osptek/devkit-fake_pod_nano_pro/tfcard/txt/说明.txt

## 组装流程和制作说明
* PCB厚度为1.0，不要打错了
* S3芯片和屏幕之间需要一个厚度1.5mm的导热硅垫，请务必不要忘记
* 电池的控制板部分可能需要稍微的扳一下以贴合USB口，然后刚好可以塞进去
* 外壳中间有滑轨，请确认塞到位，注意屏幕的玻璃有台阶，会刚好卡在外壳内，不要大力出奇迹
* 部分部件的购买链接详见附件，可自行参考
* 阻容大部分是0402，所以可能需要钢网+加热台才能焊接好
* 所有板子都已经过验证无误，有问题请检查焊接
* 外壳建议使用PLA-CF材料，尼龙材料悬空的横杠坚固度不够
* PCM5102版的耳机处的电阻470r和2.2nf，如耳机音量较小，可试着换成 68Ω + 10nF
* 实测效果：CS43131驱动耳机音量上限很高，且音质更好，但接音响时，音量反而没有PCM5102大，因为PCM5102是LINE OUT。 具体我也不太懂
* 附件提供了一个固件便捷烧录工具，一键烧录
* 制作交流群（739444215）,未尽之处请进群沟通吧，寻求帮助之前请仔细阅读本制作说明
