osptek/devkit-fake_pod_nano_pro/tfcard/night7/nocover.jpg

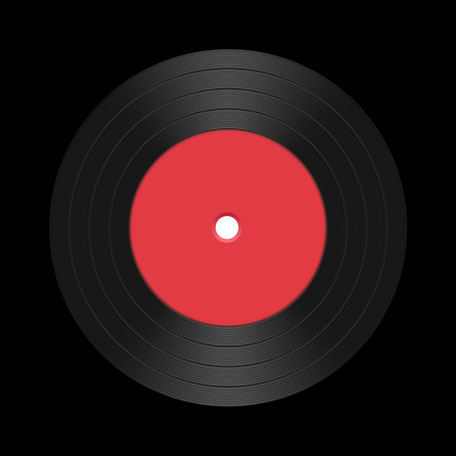
tfcard/night7/nocover.jpg
