osptek/devkit-fake_pod_nano_pro/tfcard/night7/uacbg.jpg

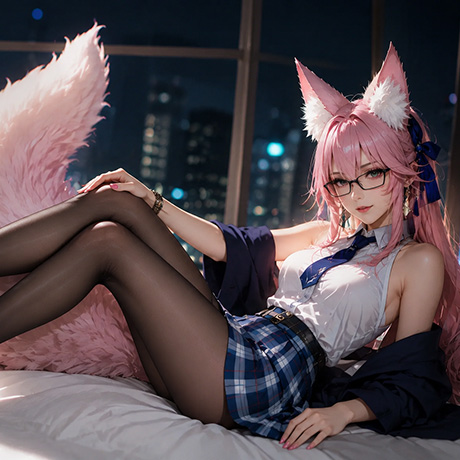
tfcard/night7/uacbg.jpg
