osptek/devkit-fake_pod_nano_pro/tfcard/pic/460_p1.jpg

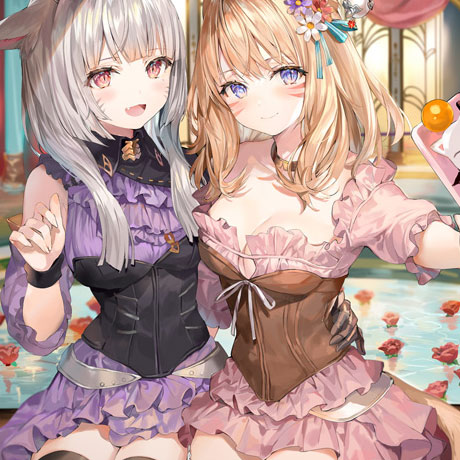
tfcard/pic/460_p1.jpg
