osptek/devkit-fake_pod_nano_pro/tfcard/pic/460_p2.jpg

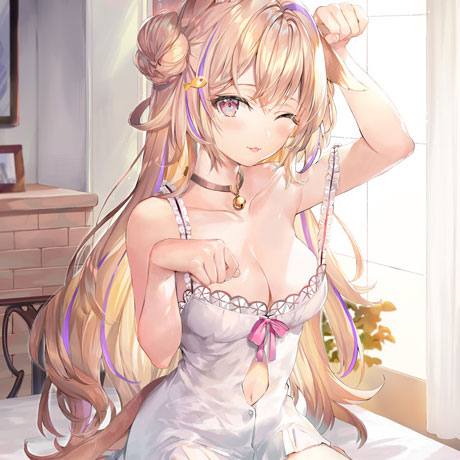
tfcard/pic/460_p2.jpg
