osptek/devkit-fake_pod_nano_pro/hardware/enclosure/FakePod_S31_LeftCover_BlackAcrylic.step

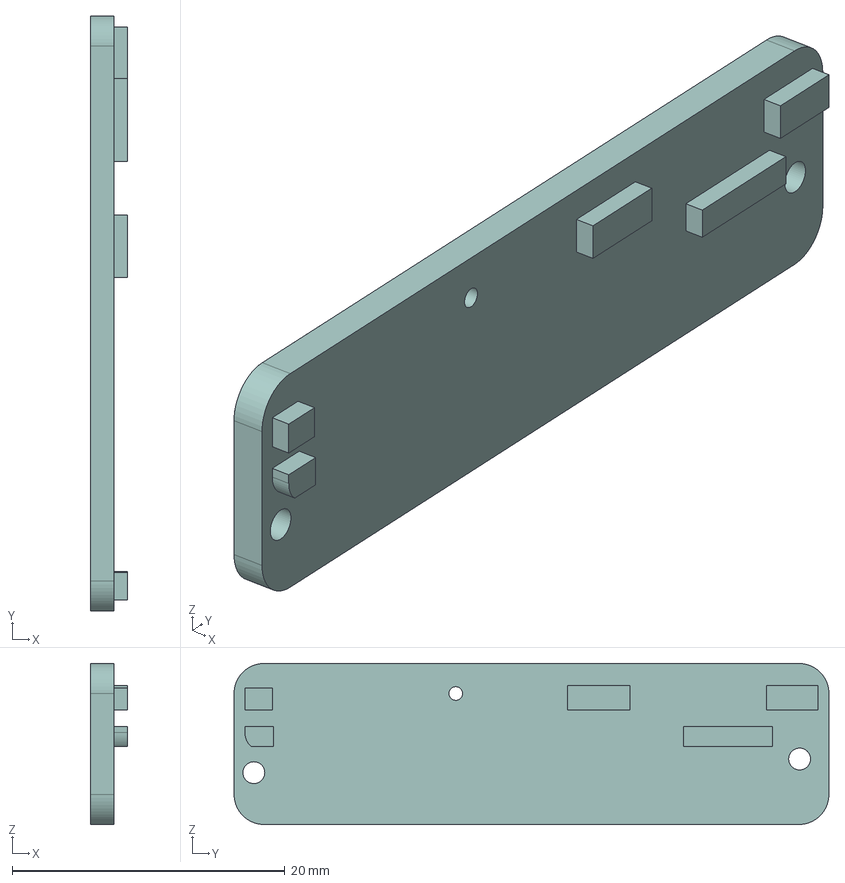
[picture p8: CAD file, 2026-11-11]
hardware/enclosure/FakePod_S31_LeftCover_BlackAcrylic.step
2.70 x 43.6 x 11.8 mm
