osptek/devkit-fake_pod_nano_pro/hardware/enclosure/FakePod_S31_Body_Aluminum_CNC.step

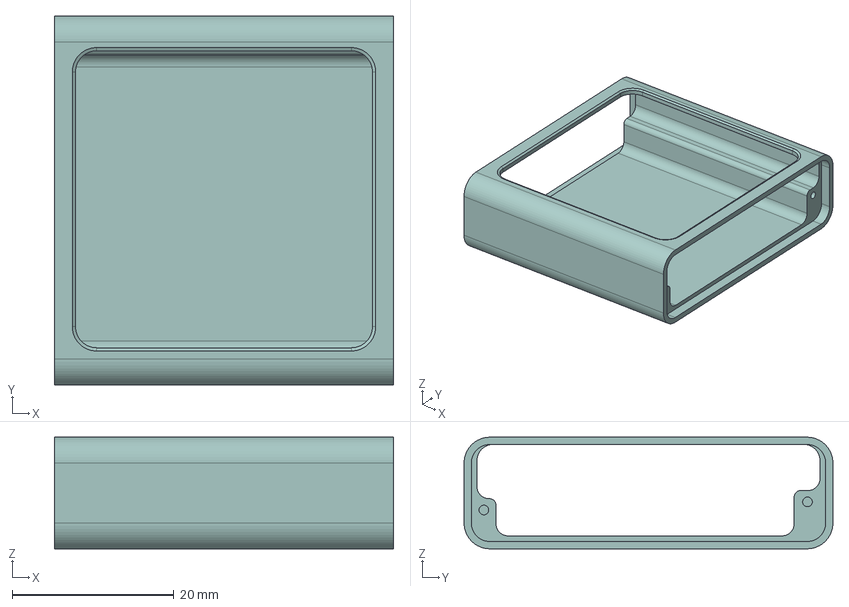
[picture p9: CAD file, 2026-11-11]
hardware/enclosure/FakePod_S31_Body_Aluminum_CNC.step
41.9 x 45.6 x 13.8 mm
