osptek/devkit-fake_pod_nano_pro/hardware/enclosure/FakePod_S31_RightCover_Aluminum_CNC.step

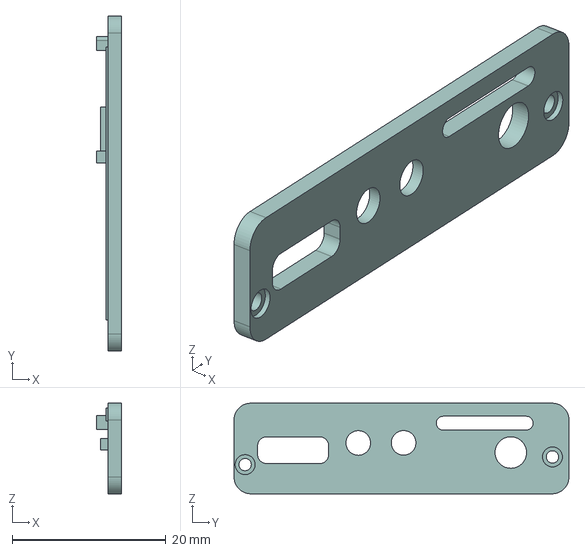
[picture p10: CAD file, 2026-11-11]
hardware/enclosure/FakePod_S31_RightCover_Aluminum_CNC.step
3.20 x 43.6 x 11.8 mm
