osptek/devkit-fake_pod_nano_pro/hardware/FakePod_S31_Schematic_V1.0.pdf

## VBUS

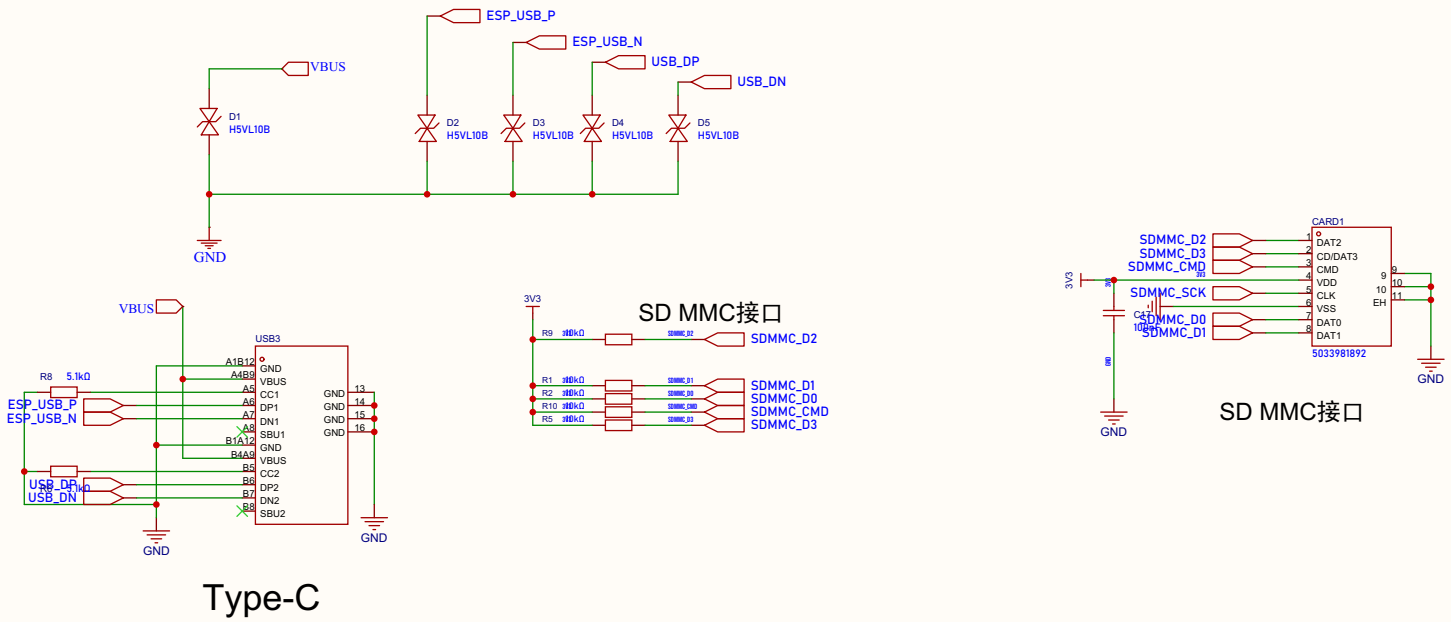
[picture p11: page 1]

GND
SBU2 B8 DN2 B7 DP2 B6 CC2 B5 VBUS B4A9 GND B1A12 SBU1 A8 DN1 A7 DP1 A6 CC1 A5 VBUS A4B9 GND A1B12

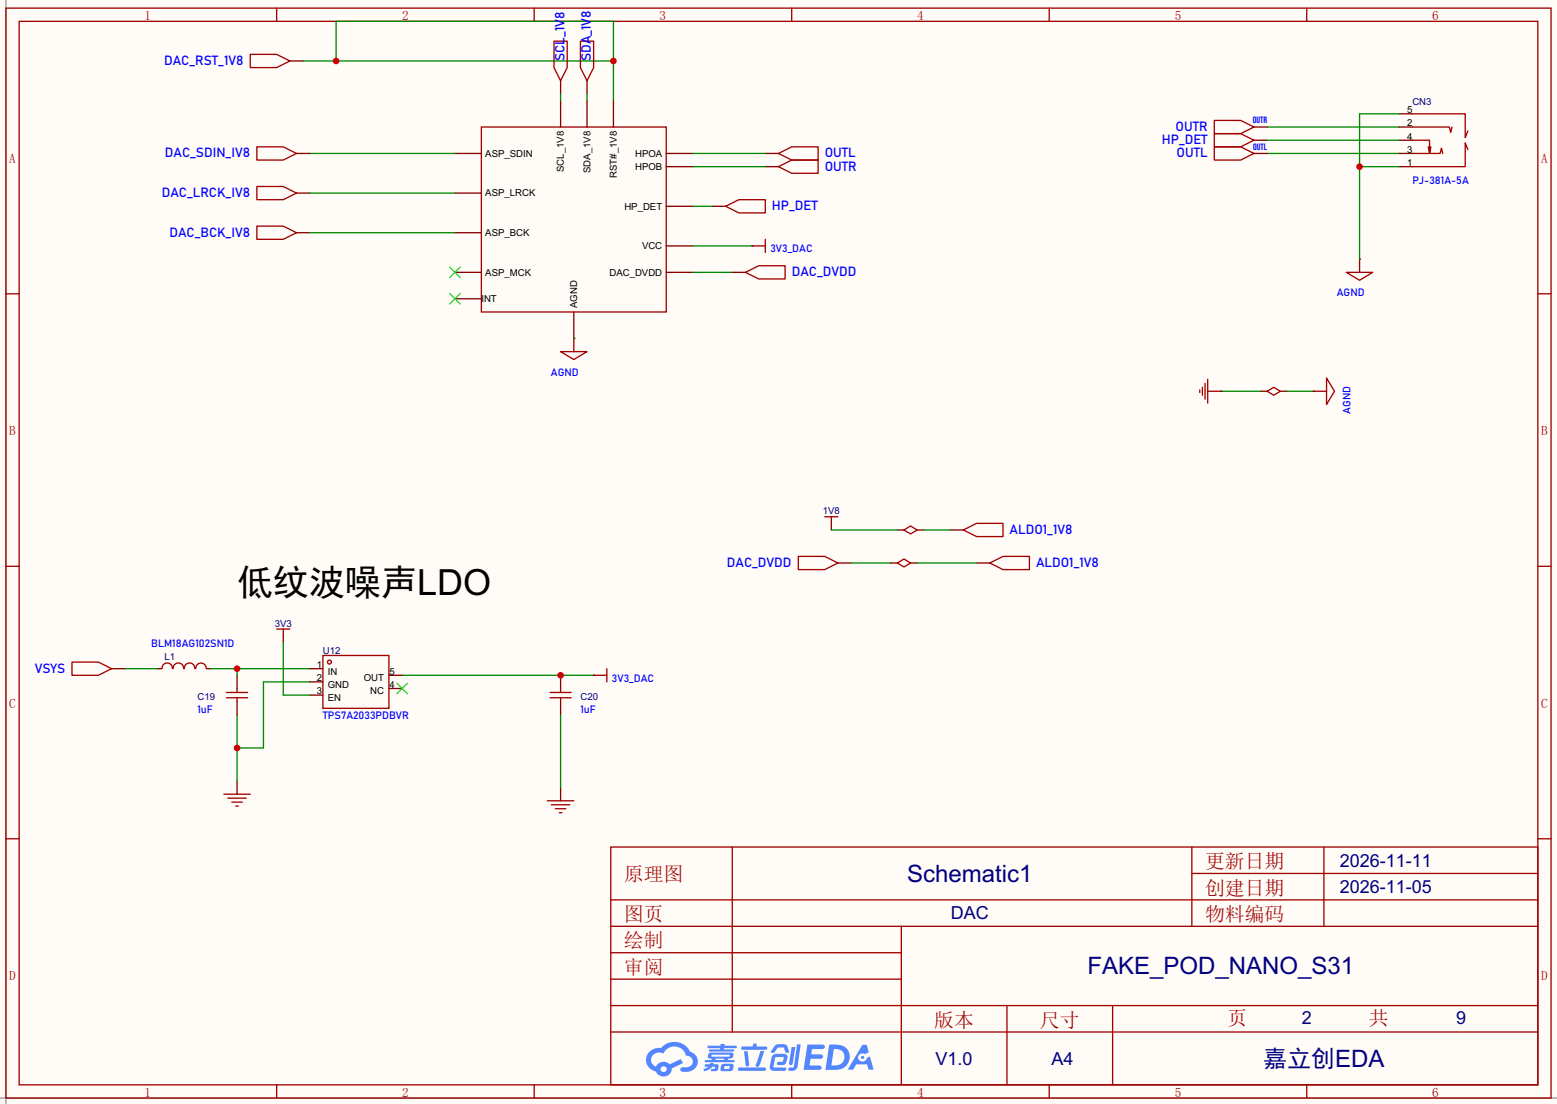
[picture p12: page 2]

AGND | AGND

### AGND

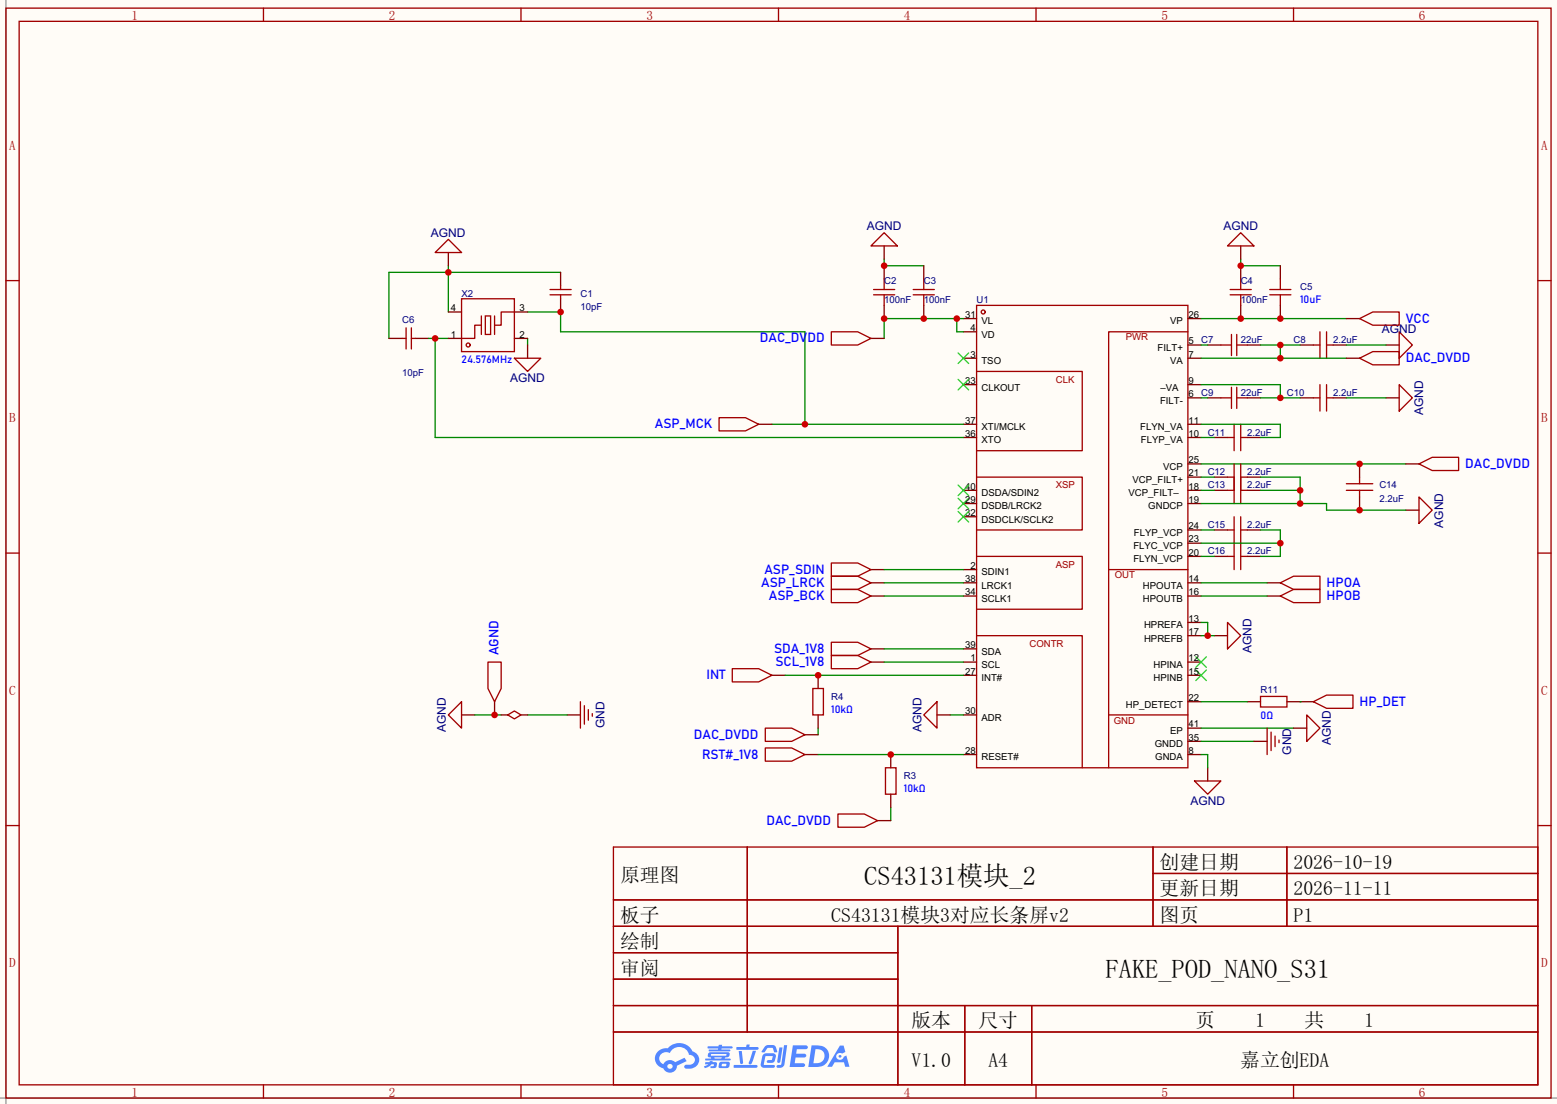
[picture p13: page 3]

原理图 | CS43131模块_2 | 创建日期 | 2026-10-19

更新日期 | 2026-11-11

板子 | CS43131模块3对应长条屏v2 | 图页 | P1
绘制 | | FAKE_POD_NANO_S31
审阅

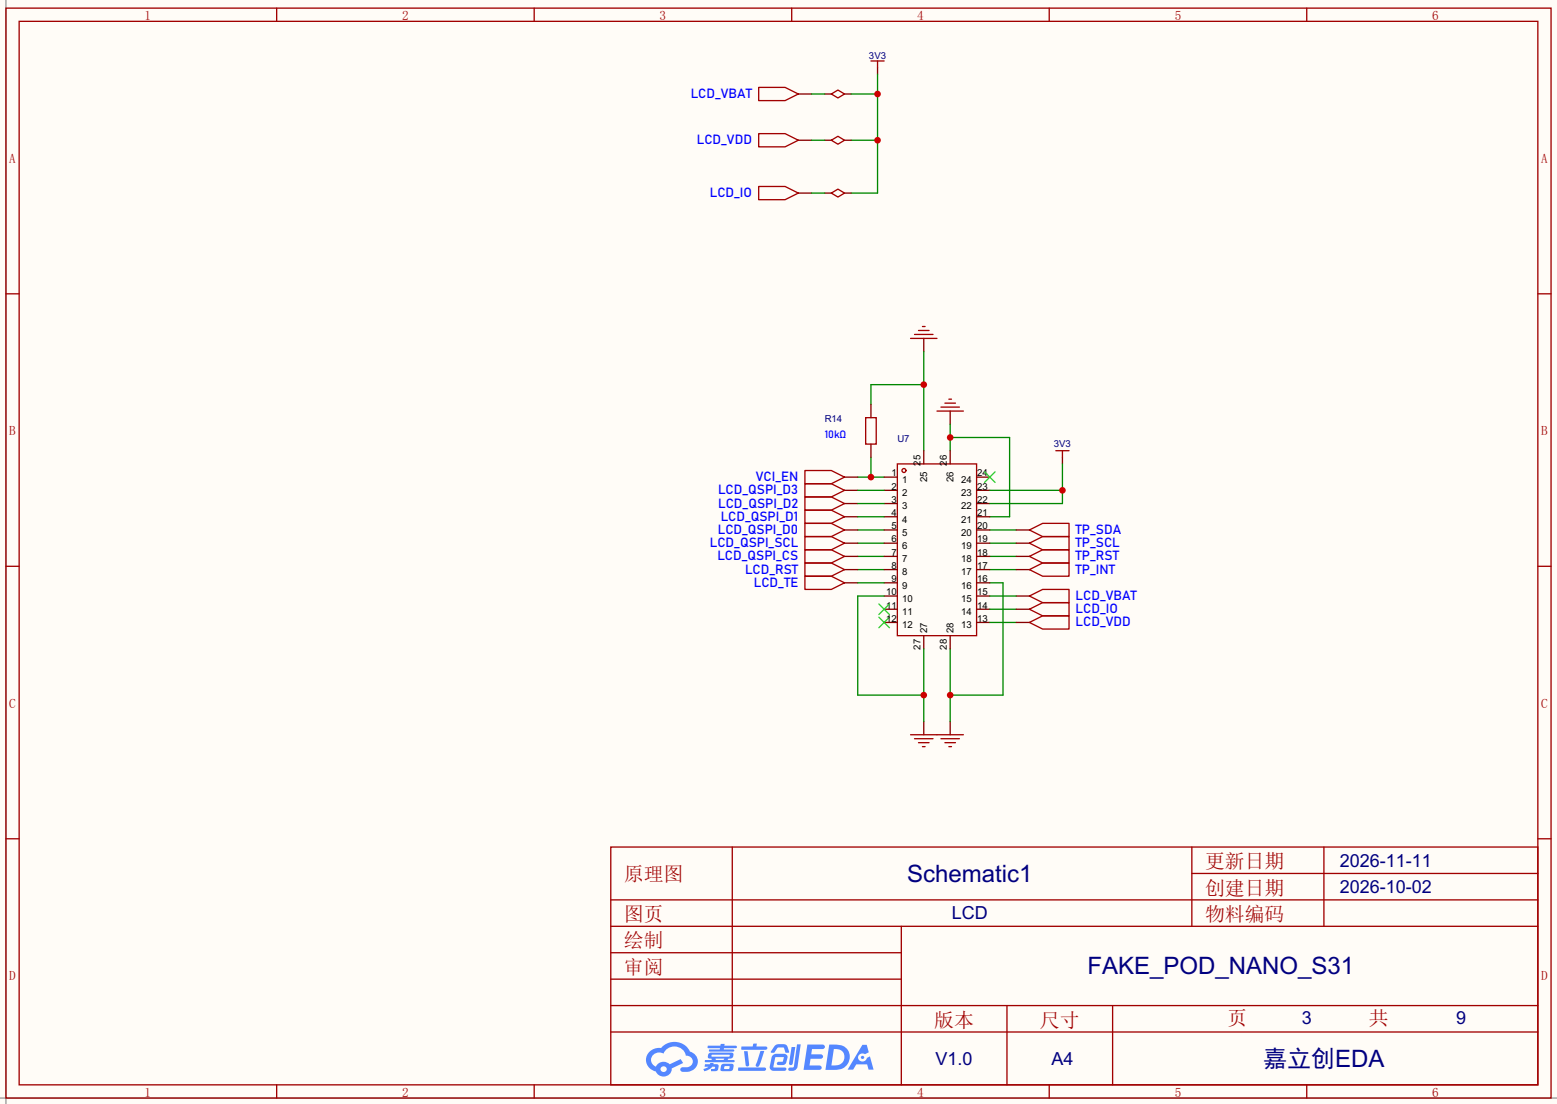
[picture p14: page 4]

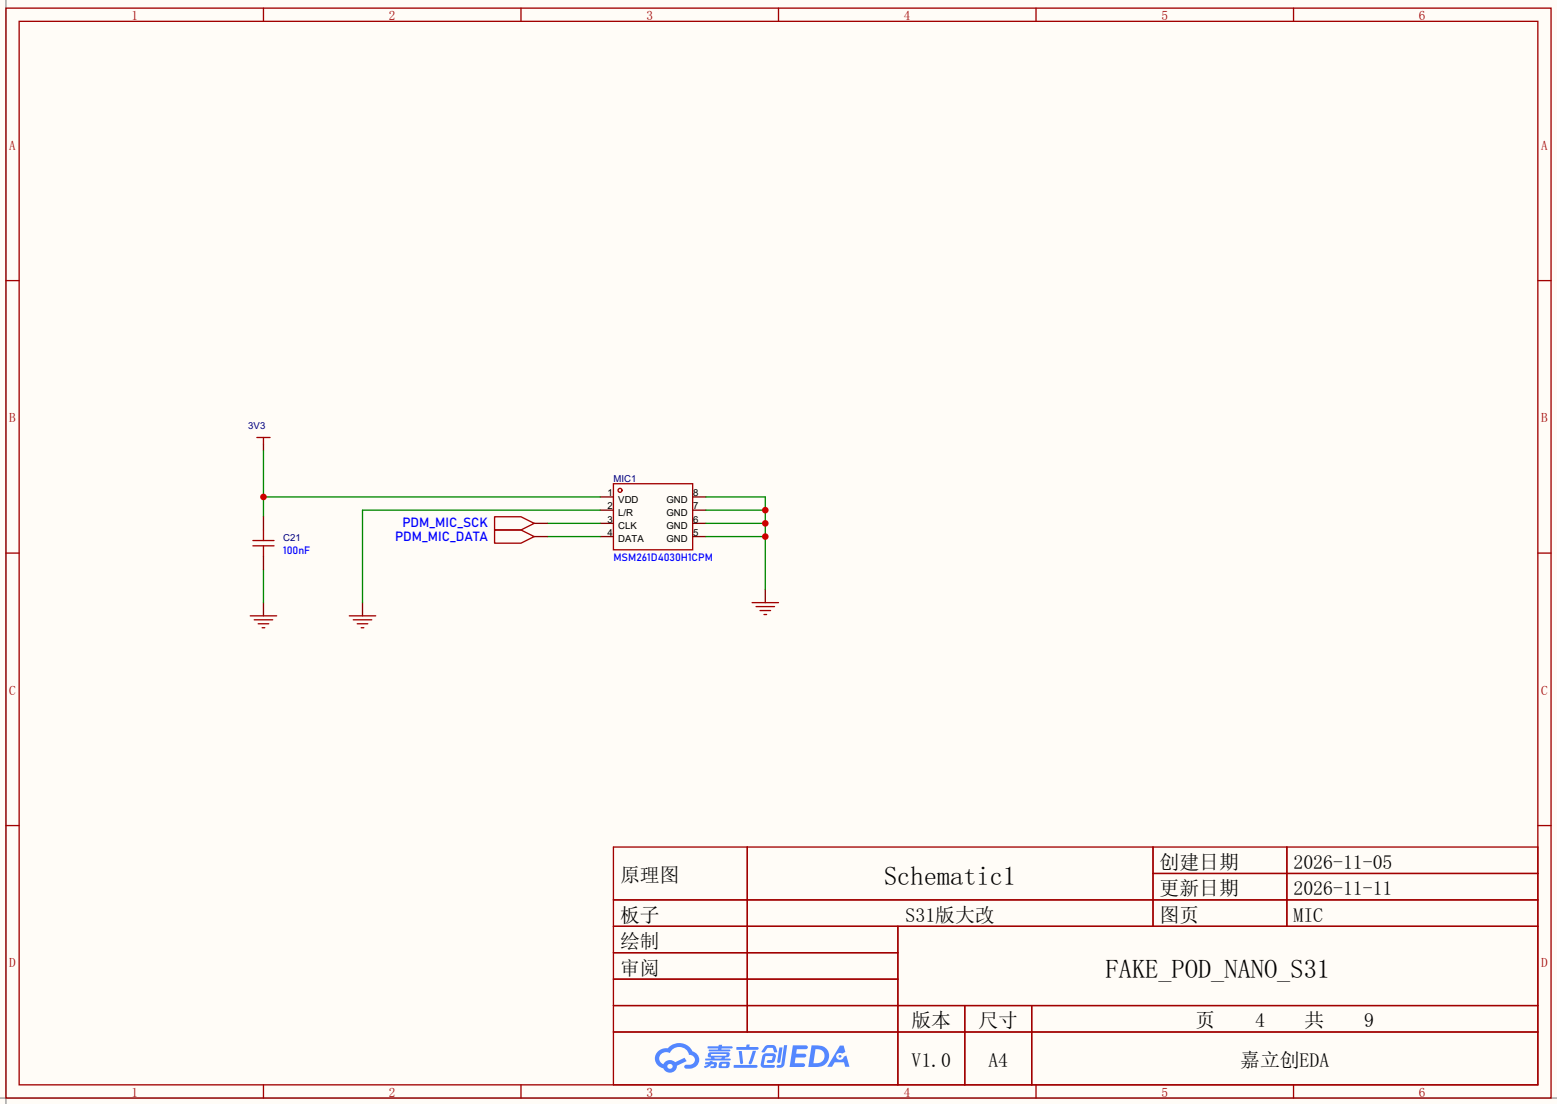
[picture p15: page 5]

原理图 | Schematic1 | 创建日期 | 2026-11-05

更新日期 | 2026-11-11

板子 | S31版大改 | 图页 | MIC
绘制 | | FAKE_POD_NANO_S31
审阅

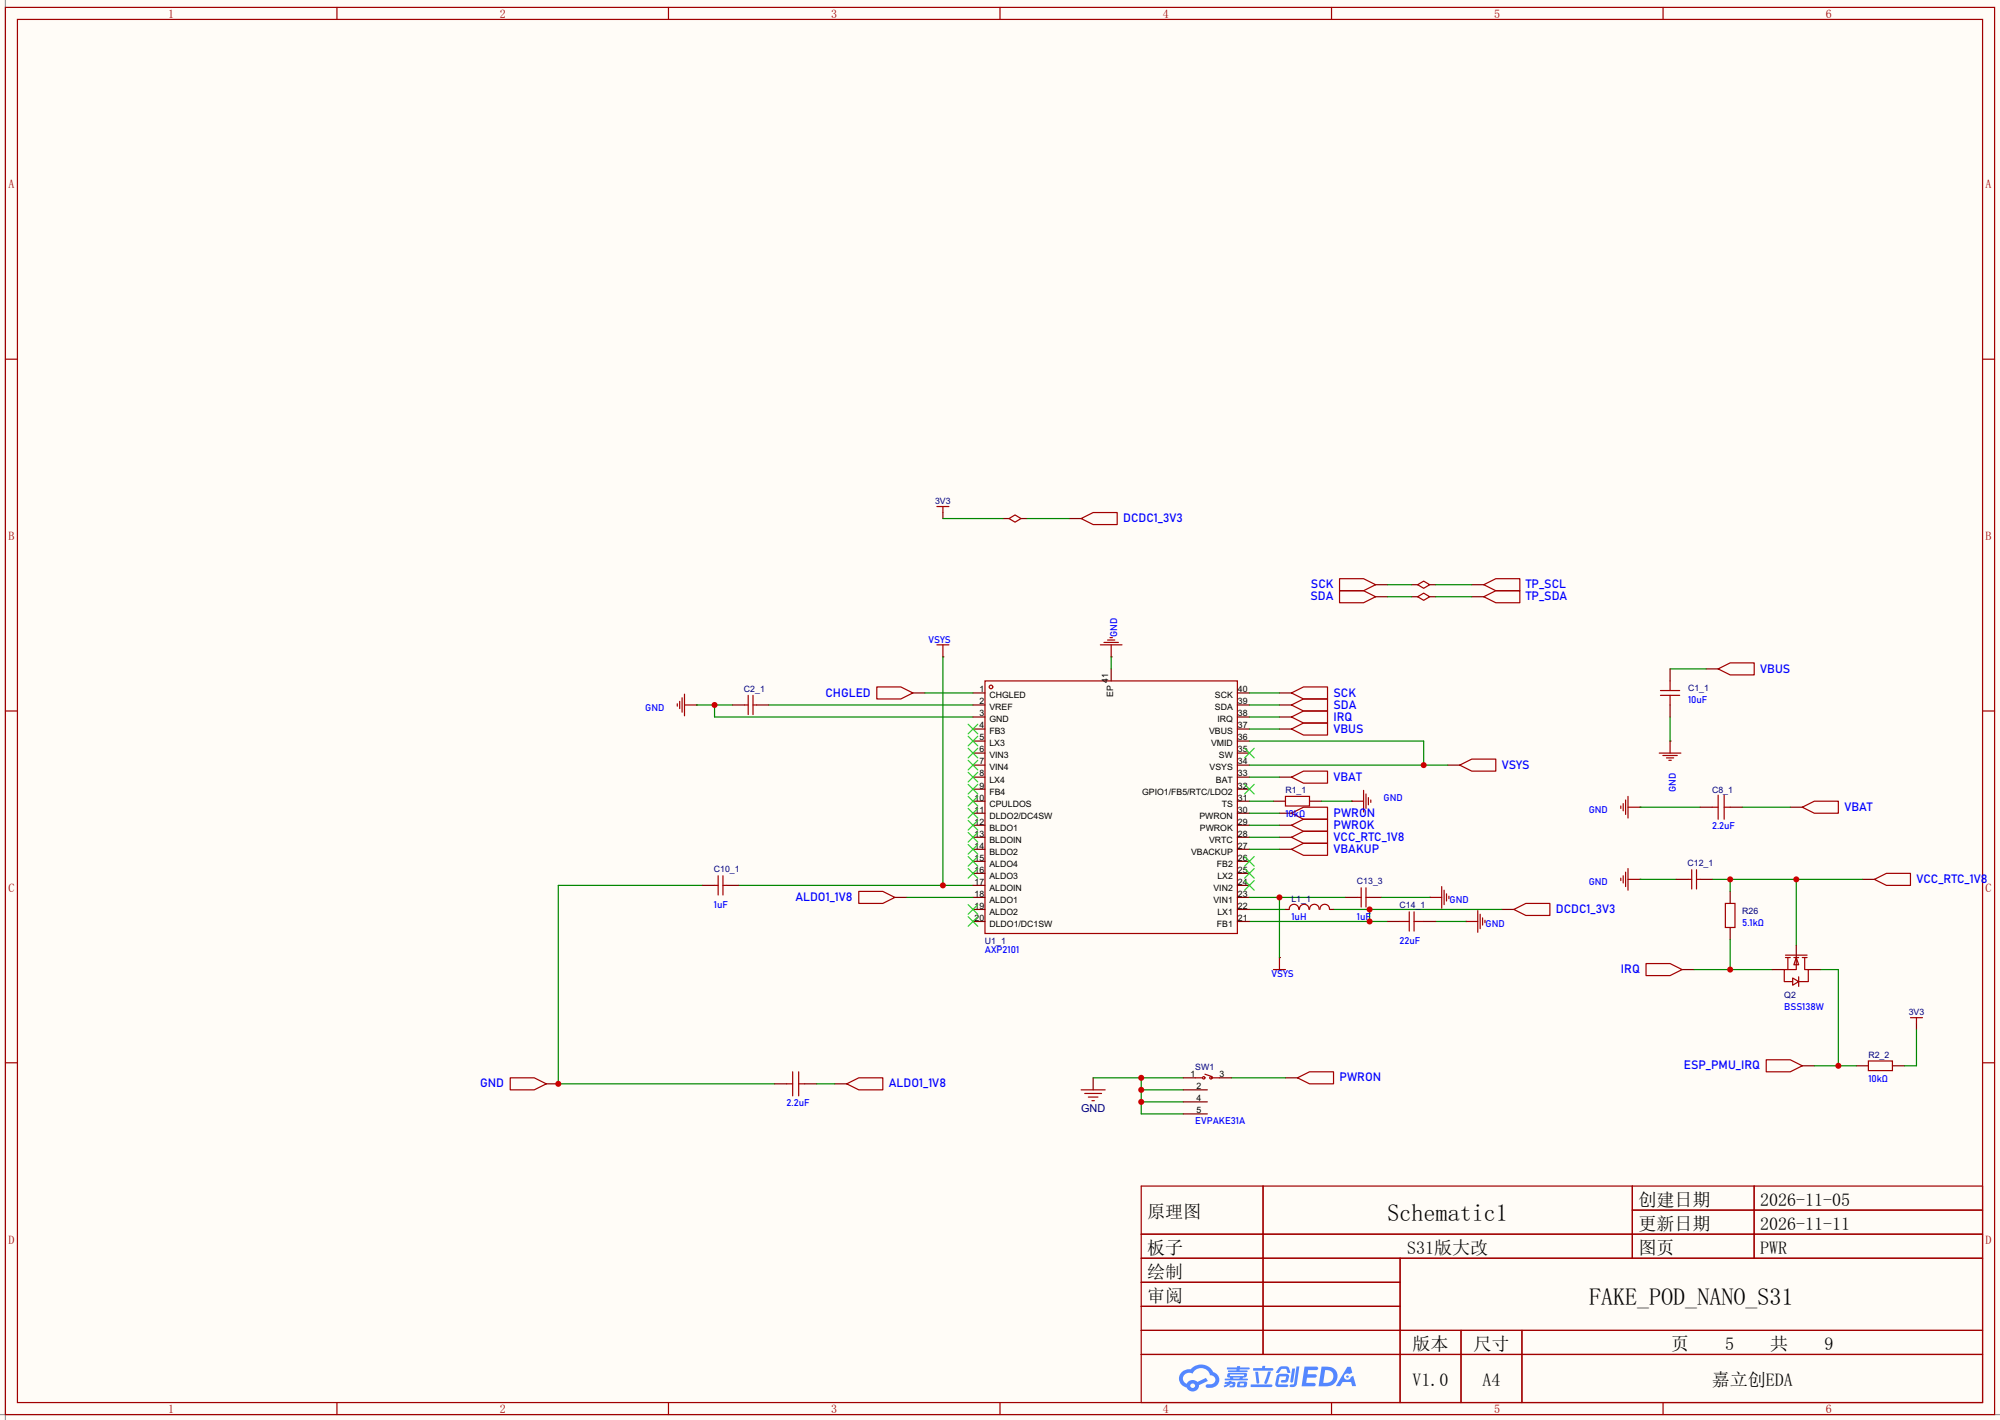
[picture p16: page 6]

原理图 | Schematic1 | 创建日期 | 2026-11-05

更新日期 | 2026-11-11

板子 | S31版大改 | 图页 | PWR
绘制 | | FAKE_POD_NANO_S31
审阅

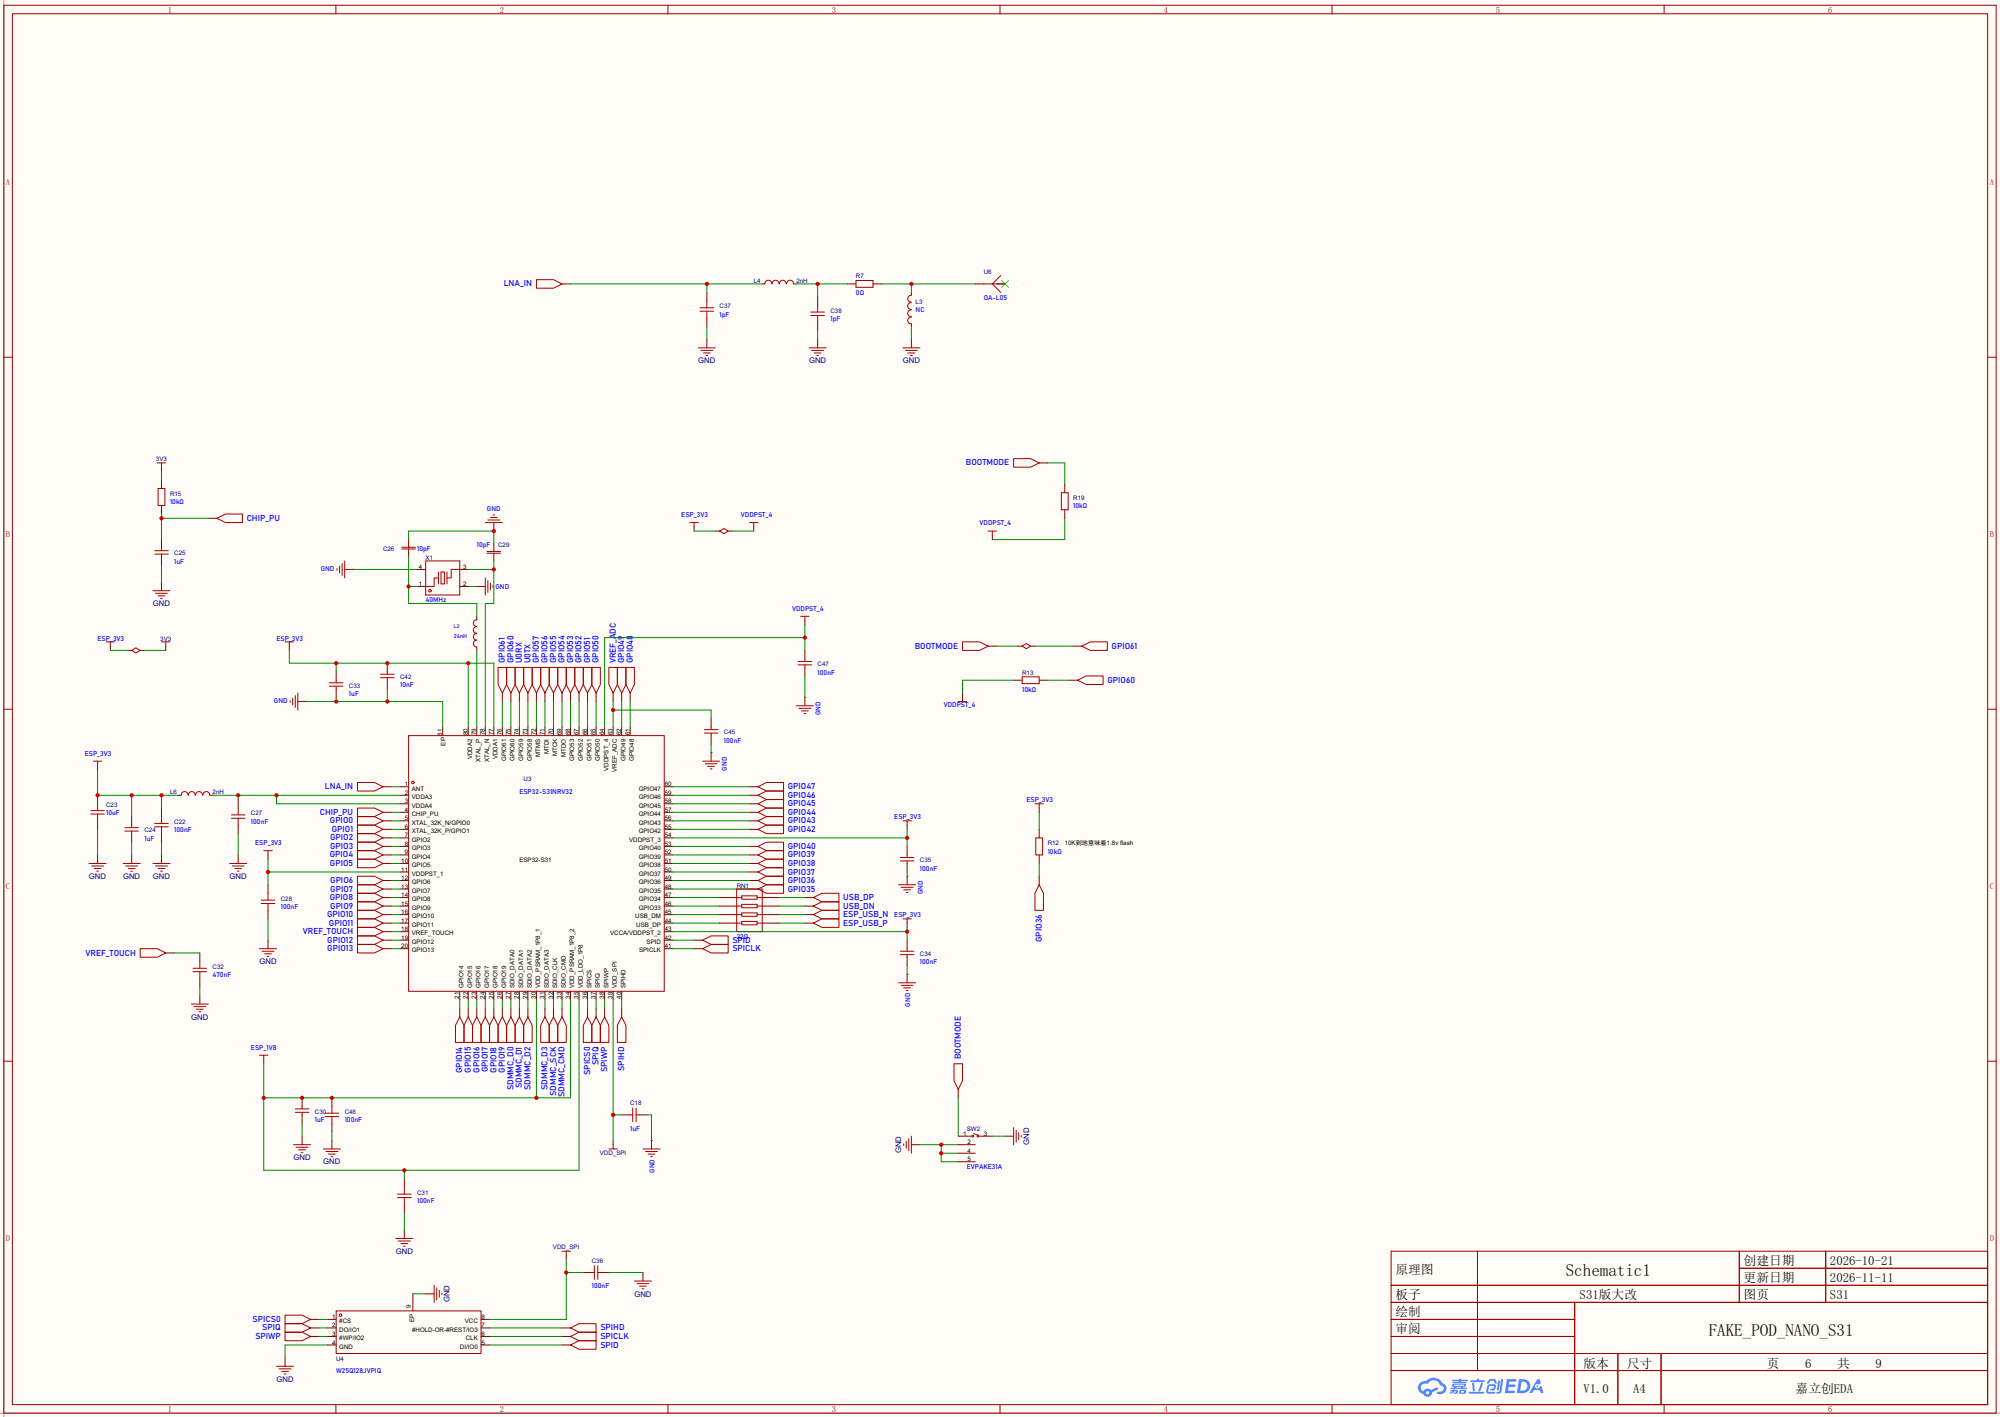
[picture p17: page 7]

SPICLK 41 SPID 42 VCCA/VDDPST_2 43 USB_DP 44 USB_DM 45 GPIO33 46 GPIO34 47 GPIO35 48 GPIO36 49 GPIO37 50 GPIO38 51 GPIO39 52 GPIO40 53 VDDPST_3 54 GPIO42 55 GPIO43 56 GPIO44 57 GPIO45 58 GPIO46 59 GPIO47 60 GPIO⁴⁸ ⁶¹ GPIO⁴⁹ ⁶² VREF_ADC ⁶³ VDDPST_4 64 GPIO⁵⁰ ⁶⁵ GPIO⁵¹ ⁶⁶ GPIO⁵² ⁶⁷ GPIO⁵³ ⁶⁸ MTDO ⁶⁹ MTCK ⁷⁰ MTDI 71 MTMS ⁷² GPIO⁵⁸ ⁷³ GPIO⁵⁹ ⁷⁴ GPIO⁶⁰ ⁷⁵ GPIO⁶¹ ⁷⁶ VDDA¹ ⁷⁷ XTAL_N ⁷⁸ XTAL_P ⁷⁹ VDDA² ⁸⁰

原理图 | Schematic1 | 创建日期 | 2026-10-21

更新日期 | 2026-11-11

板子 | S31版大改 | 图页 | S31
绘制 | | FAKE_POD_NANO_S31
审阅

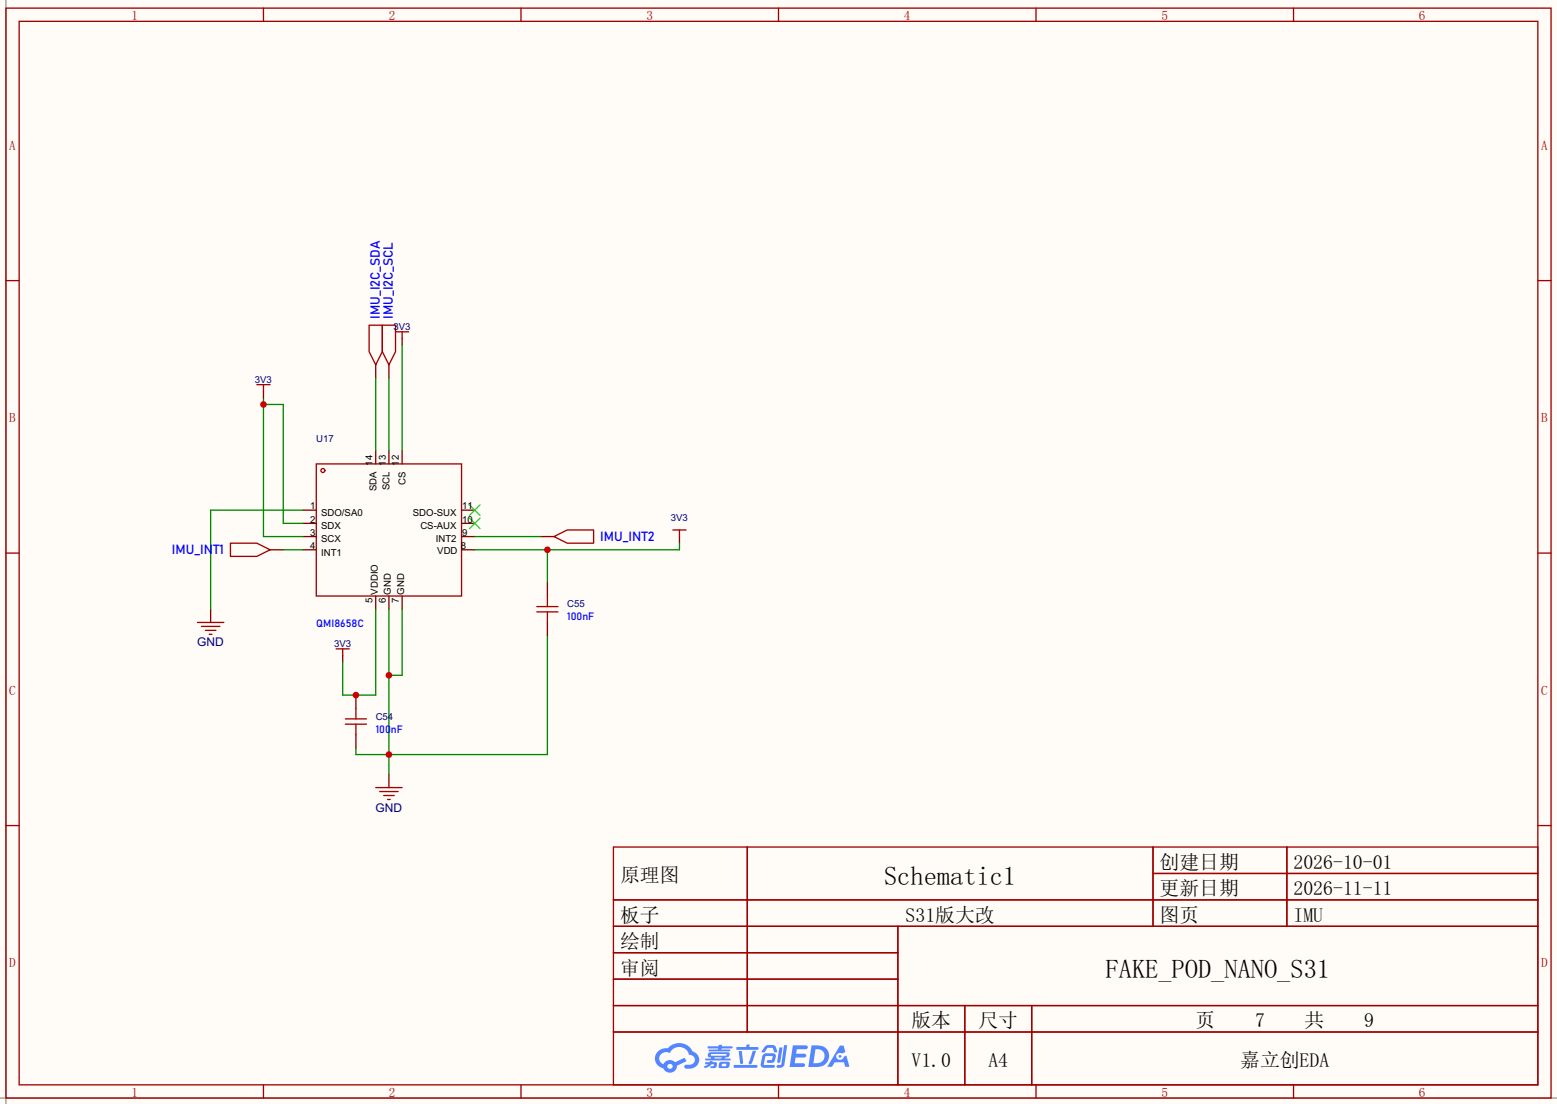
[picture p18: page 8]

CS-AUX 10 SDO-SUX 11

原理图 | Schematic1 | 创建日期 | 2026-10-01

更新日期 | 2026-11-11

板子 | S31版大改 | 图页 | IMU
绘制 | | FAKE_POD_NANO_S31
审阅

### GND

### GND

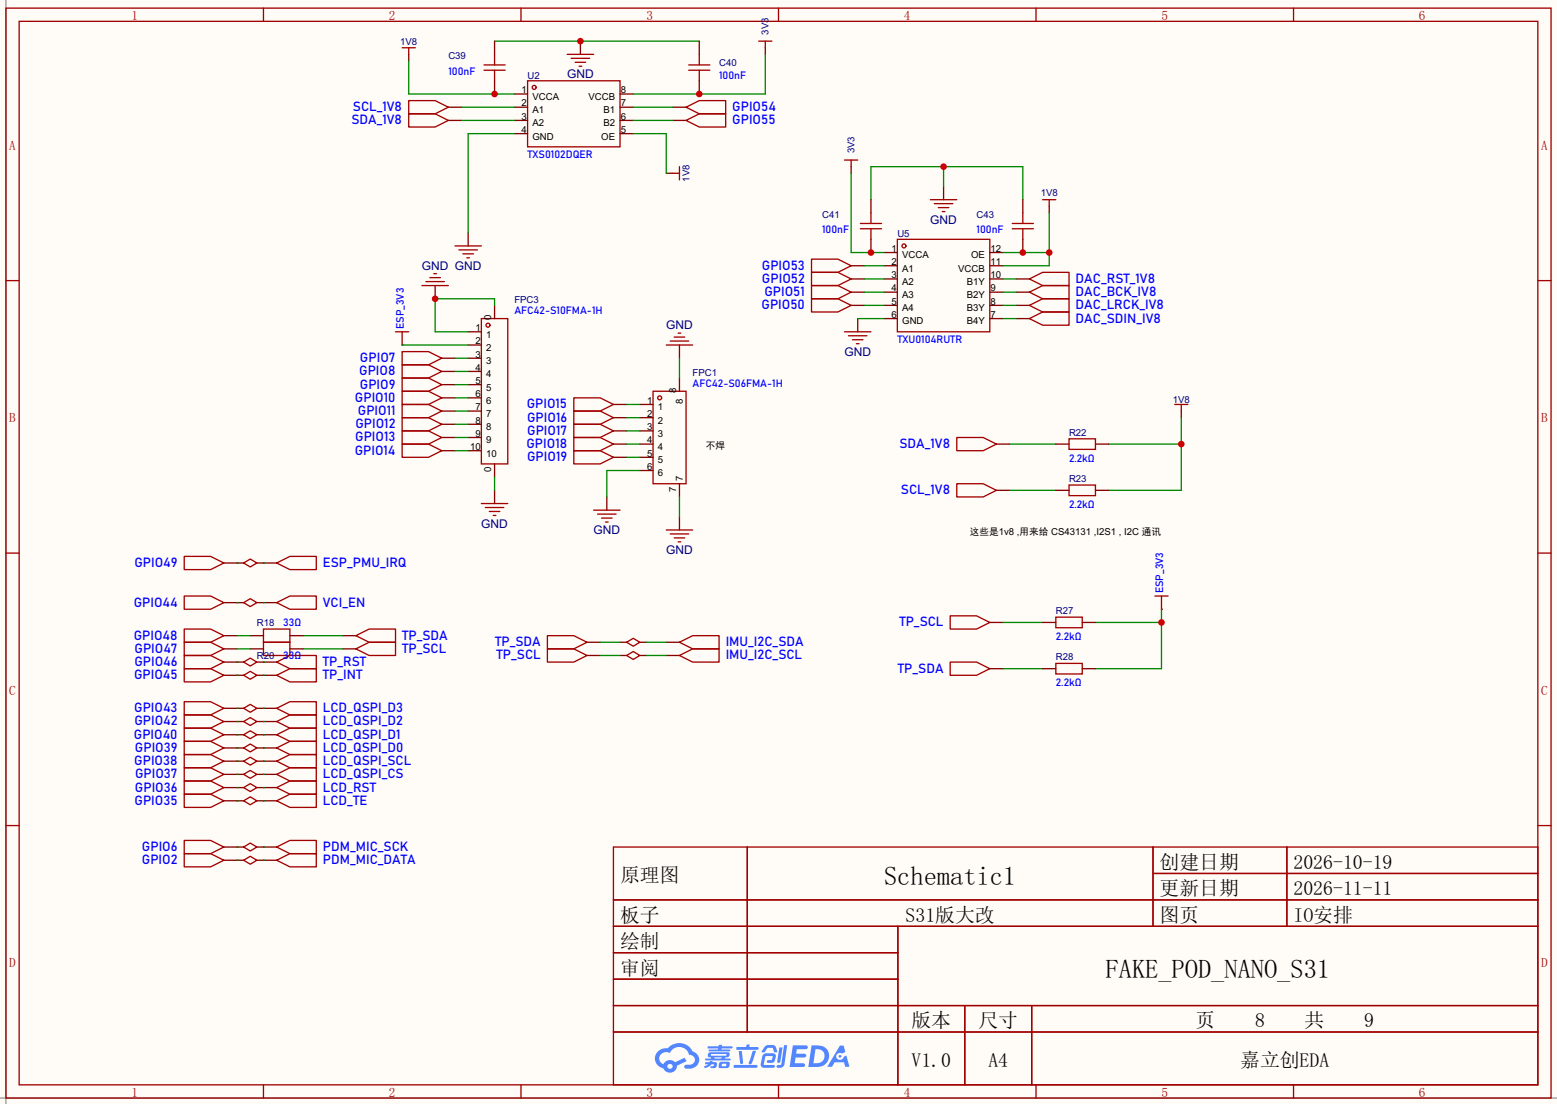
[picture p19: page 9]

原理图 | Schematic1 | 创建日期 | 2026-10-19

更新日期 | 2026-11-11

板子 | S 3 1 版 大 改 | 图页 | I O 安 排
绘制 | | FAKE_POD_NANO_S31
审阅

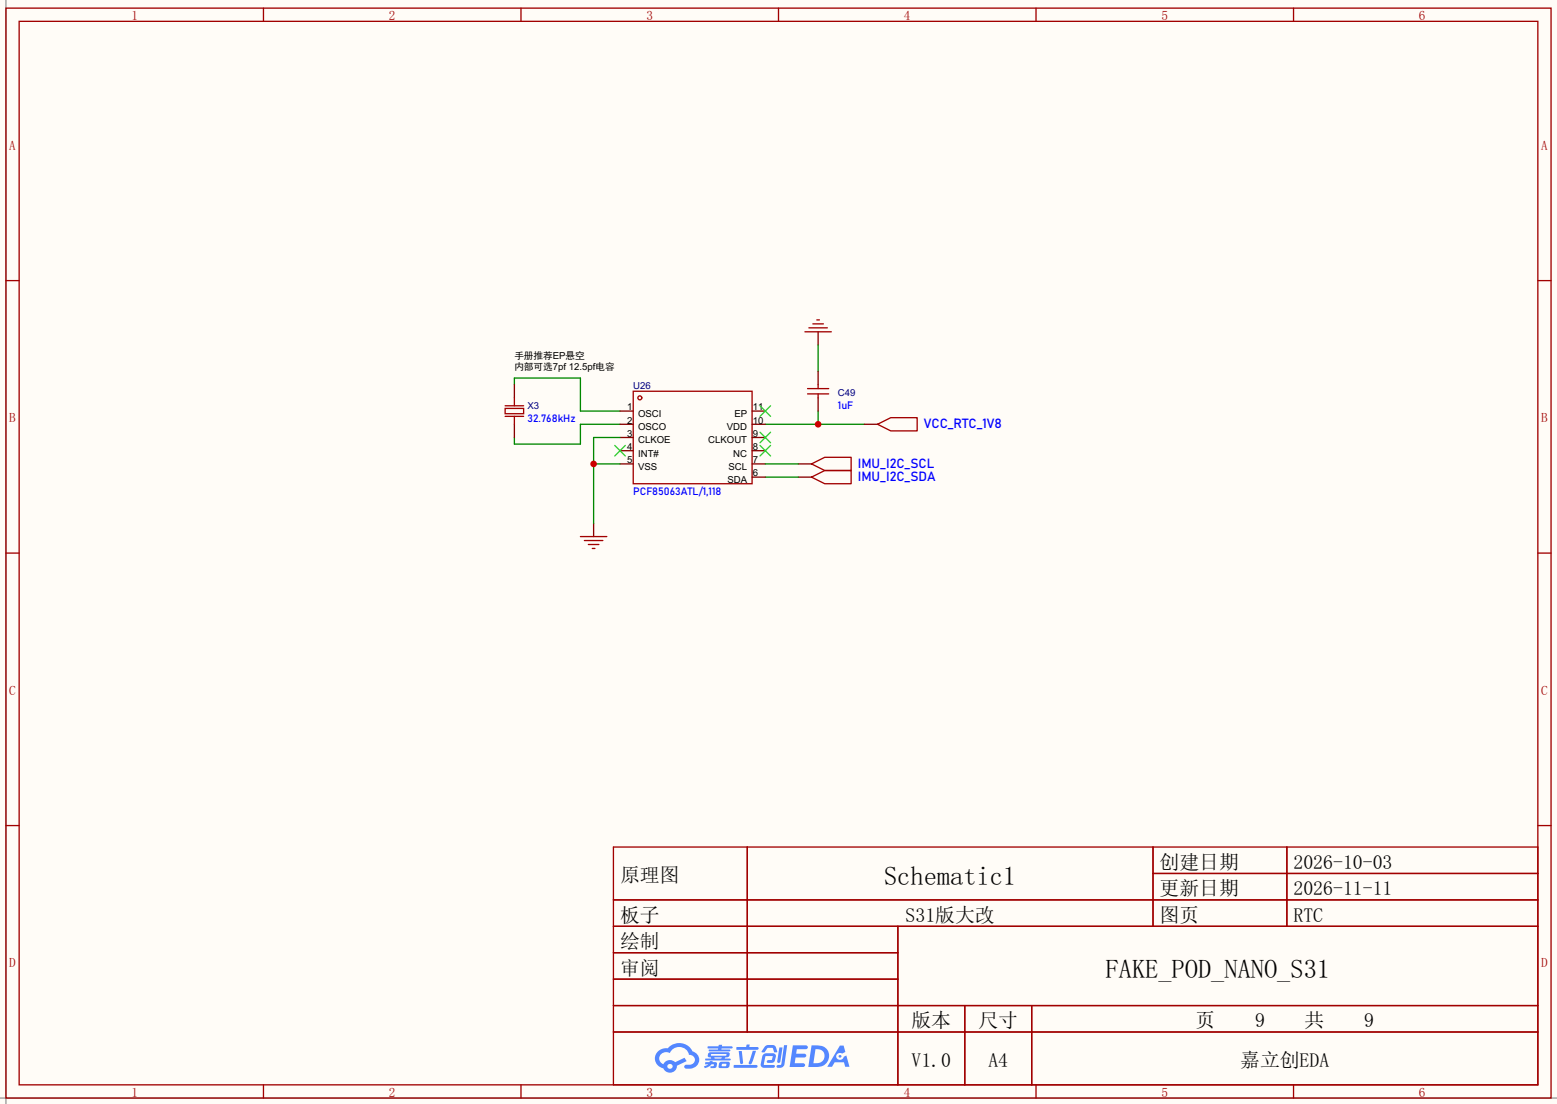
[picture p20: page 10]

原理图 | Schematic1 | 创建日期 | 2026-10-03

更新日期 | 2026-11-11

板子 | S31版大改 | 图页 | RTC
绘制 | | FAKE_POD_NANO_S31
审阅
