osptek/devkit-fake_pod_nano_pro/(commit log)

2026-11-11 Add enclosure STEP models and document them in README
    [FakePod_S31_Body_Aluminum_CNC.step, FakePod_S31_LeftCover_BlackAcrylic.step, FakePod_S31_RightCover_Aluminum_CNC.step]
2026-11-11 Add V1.0 schematic and link it in README
2026-11-11 Add microSD resource pack and PC tools
    Add tfcard/ with the firmware's microSD resources (fonts, boot assets,
    sample video, pictures, text). Music, playlists and NSF files are left
    as empty folders for copyright reasons.
    Add tools/ with SMART_CONVERTER (video to MJPEG/AVI) and the playlist
    maker, and document both in the READMEs.
